merlanura/robat/(commit log)

2018-05-28 Timing Problem vermieden
    Bei Verwendung von mehr als 2 LEDs oder anderen zeitaufwändigen Funktionen, wurden die Motoren nicht mehr angesteuert.
    Vermieden durch Beschränkung auf 2 LEDs in showDistance()
    [robat.ino]
2018-06-11 Gerber Datei für die RoBat Platine
    Mit der Gerber Datei kannst du die RoBat Platine herstellen lassen, z.B. hier: https://easyeda.com/order
2018-11-01 Servo 2 bewegt sich hin und her
2018-11-01 LED Farbe im manuellen Modus abhängig von horiz. Joystick Stellung beim Einschalten
2019-02-20 Motoranlaufsteuerung und Modusauswahl optimiert
    Manche RoBats haben einen Reset ausgeführt, wenn im manuellen Modus der
    Joystick sehr schnell ganz nach vorne oder ganz nach hinten gedrückt wird.
    Ursache ist, dass die Motoren dann mehr Strom ziehen als die Batterien
    liefern können und dadurch kurzzeitig die Versorgungsspannung zusammenbricht.
    [robat.ino]
2019-02-20 Motoranlaufsteuerung in startMotors() ausgelagert
2019-02-21 Vorherige Motorgeschwindigkeit bei Stop auf 0 setzen
2019-02-21 Dynamische Anpassung der Verzögerung beim Motorstart
2019-02-21 Reset-Problem bei der manuellen Steuerung behoben
    [robat.ino]
2019-04-11 Noten und Buzzer
2019-04-11 Beschreibung Servos
2019-04-11 Servo 2 -> Servo 3
2019-04-11 Servo 1 -> Servo 2
2019-04-11 Servo 3 -> Servo 1
2019-04-11 Servo Beschreibung vervollständigt
2019-04-11 Ultrasonic Beschreibung ergänzt und veralteten Code entfernt
2019-04-11 Init der LEDs
2019-04-11 Init der Motoren
2019-04-11 Init des Joysticks
2019-04-11 Functions Ultrasonic
2019-04-11 Entfernung der nicht benutzten tweet Funktion
2019-04-12 Beschreibung Servo-Funktionen
2019-04-12 Setup Servo, Buzzer, Motor und Modus
    [robat.ino]
2019-04-12 Setup LEDs
2019-04-12 Lizenz und Header
2019-04-12 Langsames Anlaufen der Motoren und div. Fehlerkorrekturen
2019-04-12 Anhalten der Motoren mit stopMotors()
2019-04-12 Bugfix bei stopMotors() Aufruf
    [robat.ino]
2021-12-10 OLED Display (i2c) hinzugefügt
2021-12-10 Anzeige der Entfernung zum nächsten Objekt auf dem OLED Display
2024-12-16 Define adjustable turning times for the robot in milliseconds.
2026-04-14 Replace swivelling of servo1 by toggle on button
    [robat.ino]
2026-04-26 Fix a bug whith timing for Servo 1
    [robat.ino]
2026-04-26 Optimize gripper calibration
2026-04-26 Fix a bug where servo angles were mapped twice
    [robat.ino]
2026-04-27 Do not move servo 1 on startup
2026-05-02 Set MANUAL mode as default on startup and during calibration.
2026-05-02 Reduce wheel speed when steering
2026-05-02 Revert steering direction when driving backwards
    [robat.ino]
